dscohen/bike_necksaver/(commit log)

2026-09-19 Add parametric periscope housing, design notes, and README
    Bike periscope for seeing the road while riding with head pitched down.
    Includes the optics derivation (single-mirror image inversion, two-mirror
    correction) and a parametric OpenSCAD model with a drop-in 160x100mm
    mirror channel and slotted stem-faceplate mount.
    [periscope.scad]
2026-09-19 Fix periscope optics and build out the two-mirror design
    The model conflated a mirror normal's tilt with its angle of incidence.
    Those differ (at theta=60 the single mirror's normal tilts 30 degrees but
    sits at 60 degrees of incidence), so foreshortening and every aperture and
    FOV number were overstated. Mirror placement is now derived by tracing the
    actual sightline -- normals come from unit(d2 - d) and incidence from
    acos(-d . n) -- so the two can no longer drift apart.
    The two-mirror build is now a real assembly rather than two stacked
    plates: mirrors sit where the reflected ray puts them, the support arm is
    cut off against the back of the mirror instead of spearing through its
    face, and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
    [periscope.scad]
2026-09-19 Correct the belay-glasses claim, rule out prisms, default to the periscope
    The notes claimed belay glasses stay upright because the belayer's head
    does not rotate. That is wrong: head orientation has no bearing on parity,
    and a single reflection inverts in the plane of the fold regardless. A car
    rear-view mirror is the everyday check -- one reflection, left-right
    flipped, vertical fine, because that fold is horizontal. Rotate the
    geometry and the flipped axis rotates with it.
    It mattered because the claim was load-bearing: it implied a single fold
    could be rescued by mounting it cleverly. It cannot, so the single-mirror
    rig is demoted to an adaptation experiment and the two-mirror periscope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
    [periscope.scad]
2026-09-19 Rebuild the periscope as an enclosed box that hangs under the stem
    The previous model was an open rod truss with a flat mount plate and a
    330mm mast standing in front of the rider's face. None of that survives
    contact with a bike. This version is a light-tight tube that follows the
    beam: three straight legs joined at two mirror pockets, drawn as a 2D
    fold-plane profile and extruded, so the box is the ray path with walls on
    it rather than a convex hull around the mirrors.
    Layout is the mirror image of the old one. Reversing the ray path swaps
    the two incidence angles but keeps the aperture, and turns the mast into
    a box hanging below and ahead of the faceplate -- the out-front light
    zone, ab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
    [periscope.scad]
2026-09-20 Add a 1:1 paper template and a pre-print checklist
    Four inputs in the model are still guesses -- head pitch, both faceplate
    bolt spacings, and mirror thickness -- and the box is a 133 x 167 x 235 mm
    print, so getting them wrong is expensive. Nothing had validated the
    geometry against an actual bike either; the box hangs ~208mm below the
    faceplate and reaches ~131mm forward, which puts it over the front tire.
    part="template" exports the fold-plane profile as a 1:1 SVG: cut outline,
    the two mirror lines to tape tiles along, the beam corridors to keep
    clear, the faceplate position for holding it up to the bike, and a 100mm
    ruler so a rescaled printout is caught immediately. Sized to 184 x 264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
    [periscope.scad]
